EIT-team/Lulzbot_TAZ6_Stuff/Camera_Mount/images/a3205602460fbbdce965ac1f9e4c987e_preview_featured.jpg

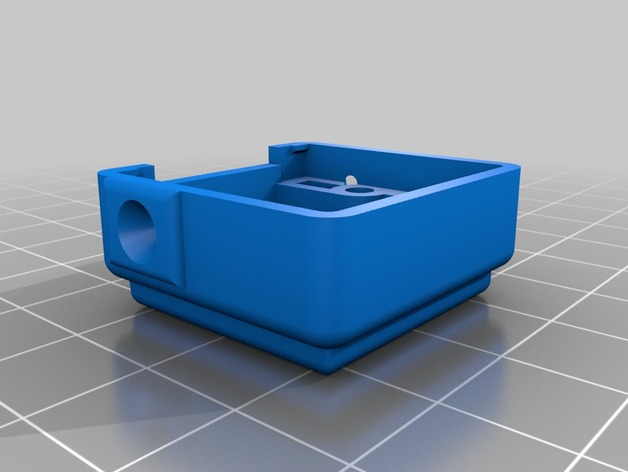
Camera_Mount/images/a3205602460fbbdce965ac1f9e4c987e_preview_featured.jpg
