EIT-team/Lulzbot_TAZ6_Stuff/Spool_holder/images/ad2b357367d83386ae0fbfb51b6cadb3_preview_featured.JPG

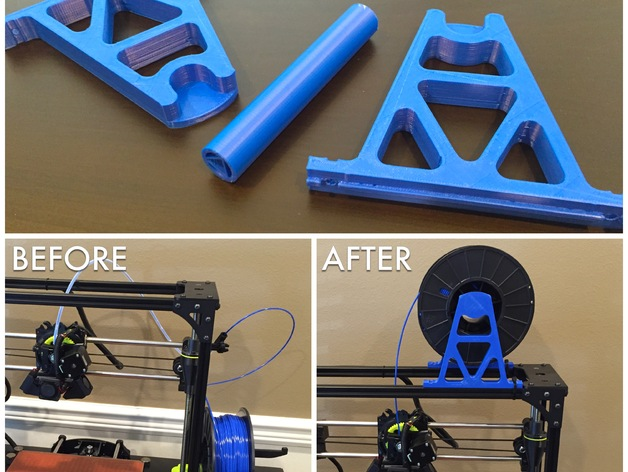
Spool_holder/images/ad2b357367d83386ae0fbfb51b6cadb3_preview_featured.JPG
