EIT-team/Lulzbot_TAZ6_Stuff/Camera_Mount/images/7fdee502b70e45b4f5864df7f136ed26_preview_featured.JPG

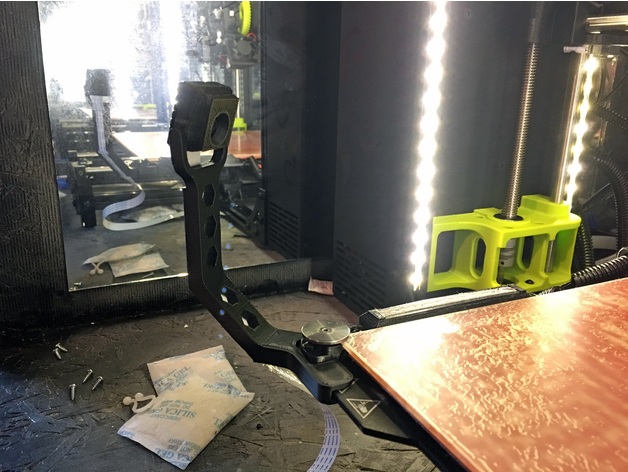
Camera_Mount/images/7fdee502b70e45b4f5864df7f136ed26_preview_featured.JPG
