EIT-team/Lulzbot_TAZ6_Stuff/Camera_Mount/images/425e3a9a2d6e7629a2fc0dd1533b383d_preview_featured.JPG

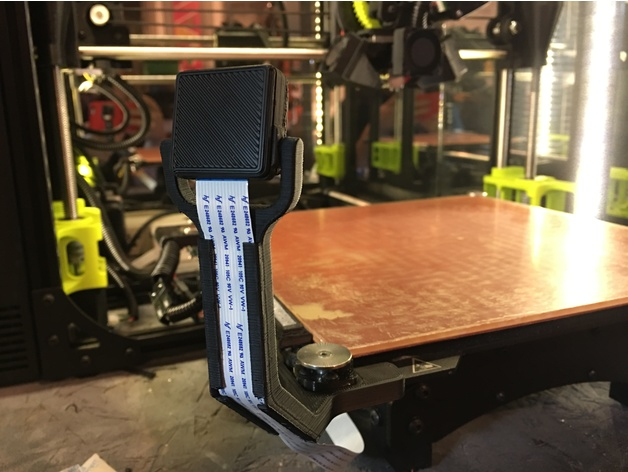
Camera_Mount/images/425e3a9a2d6e7629a2fc0dd1533b383d_preview_featured.JPG
