EIT-team/Lulzbot_TAZ6_Stuff/Camera_Mount/images/969a5c4e11afb6a8e6aaa260e8c08da8_preview_featured.jpg

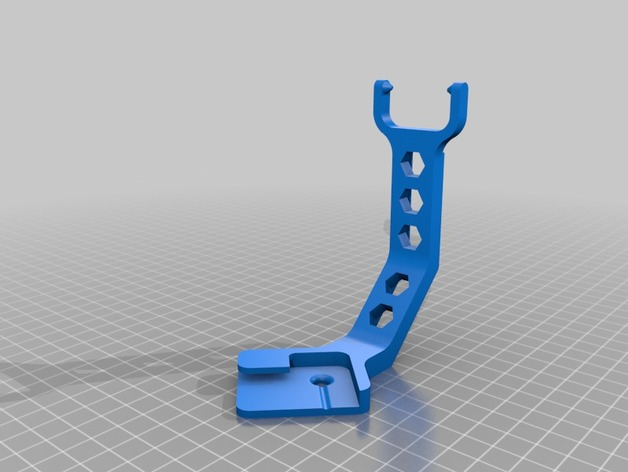
Camera_Mount/images/969a5c4e11afb6a8e6aaa260e8c08da8_preview_featured.jpg
