EIT-team/Lulzbot_TAZ6_Stuff/Camera_Mount/images/603722a2154b18a745f2940e1e3ba9a8_preview_featured.jpg

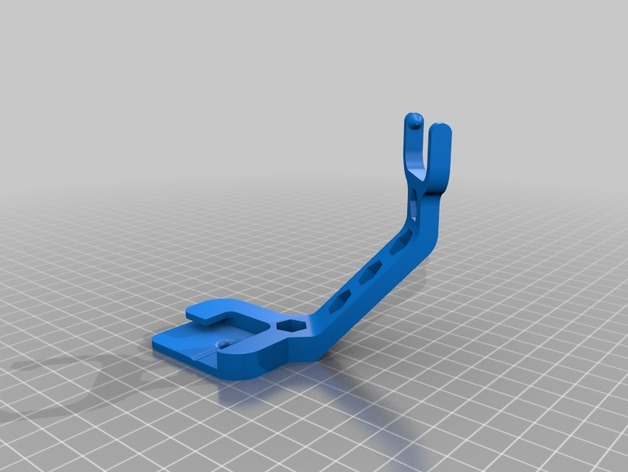
Camera_Mount/images/603722a2154b18a745f2940e1e3ba9a8_preview_featured.jpg
