EIT-team/Lulzbot_TAZ6_Stuff/Camera_Mount/images/ca3ec1ea09c678b3015d4c37807ddfab_preview_featured.jpeg

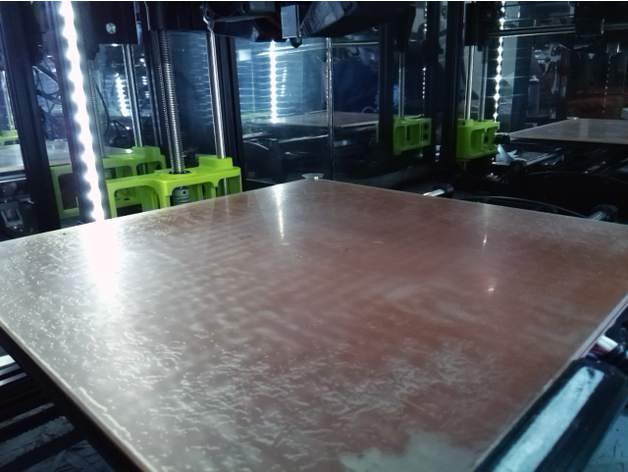
Camera_Mount/images/ca3ec1ea09c678b3015d4c37807ddfab_preview_featured.jpeg
