EIT-team/Lulzbot_TAZ6_Stuff/Spool_holder/images/2ec2b8d2024acbcaface70489fa3a40f_preview_featured.jpg

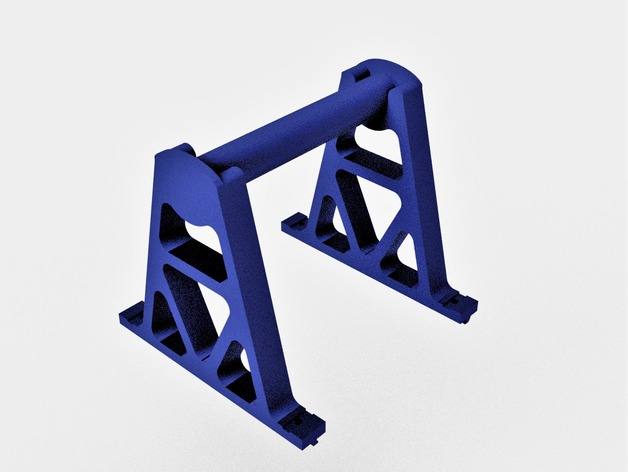
Spool_holder/images/2ec2b8d2024acbcaface70489fa3a40f_preview_featured.jpg
