EIT-team/Lulzbot_TAZ6_Stuff/Spool_holder/images/14ede1b06ad91b893148e72bddfda450_preview_featured.jpg

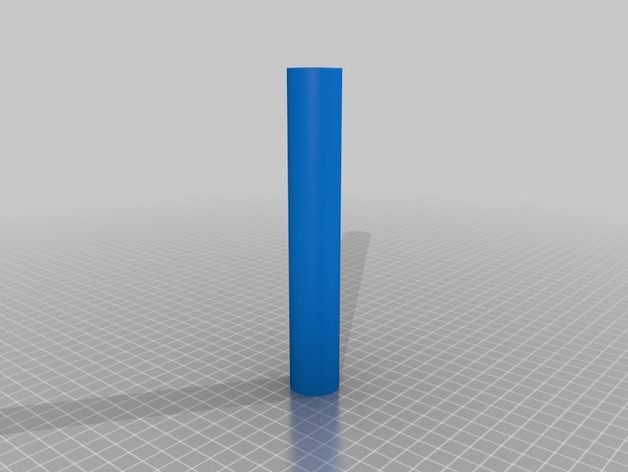
Spool_holder/images/14ede1b06ad91b893148e72bddfda450_preview_featured.jpg
