EIT-team/Lulzbot_TAZ6_Stuff/Spool_holder/images/26fea92ff83ab8327c555f57df6255c9_preview_featured.JPG

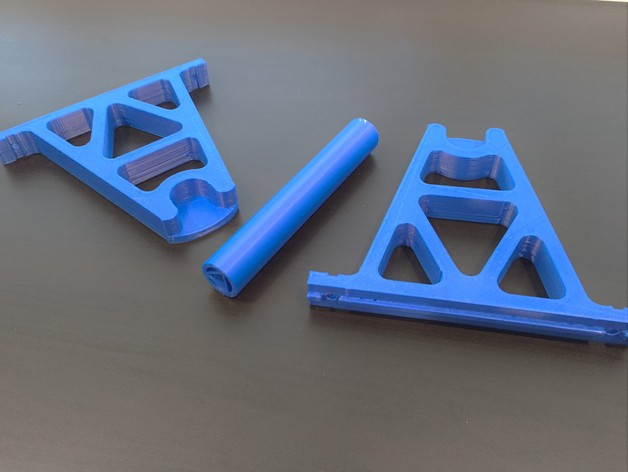
Spool_holder/images/26fea92ff83ab8327c555f57df6255c9_preview_featured.JPG
