EIT-team/Lulzbot_TAZ6_Stuff/Spool_holder/images/42b8552c151d47d23c200a5aa9578fc7_preview_featured.JPG

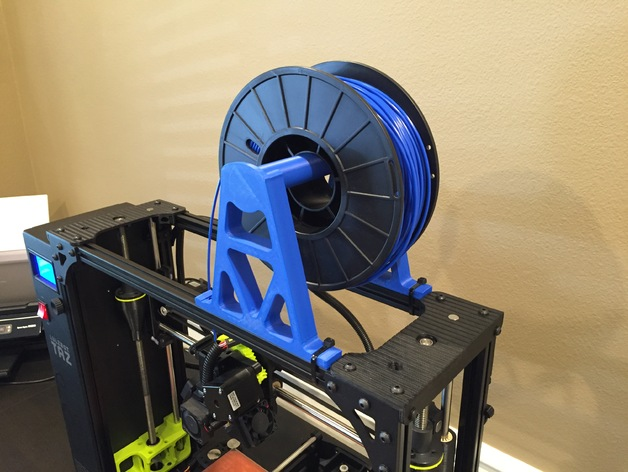
Spool_holder/images/42b8552c151d47d23c200a5aa9578fc7_preview_featured.JPG
