EIT-team/Lulzbot_TAZ6_Stuff/Spool_holder/images/520cf66f8c995ce6bb19e844736197bf_preview_featured.JPG

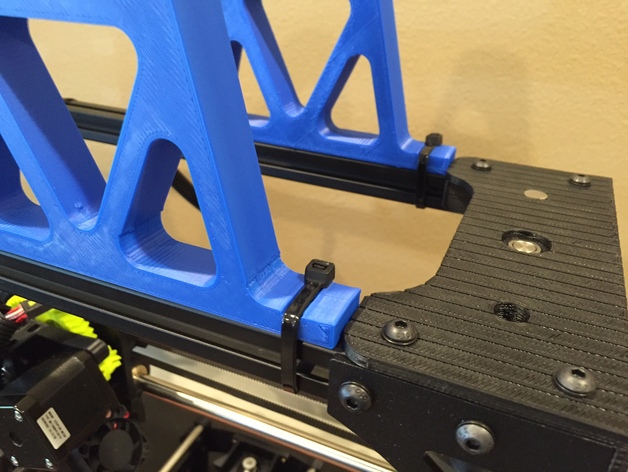
Spool_holder/images/520cf66f8c995ce6bb19e844736197bf_preview_featured.JPG
