EIT-team/Lulzbot_TAZ6_Stuff/Spool_holder/images/714c1ff9d83f5040b42f4c38db04033b_preview_featured.jpg

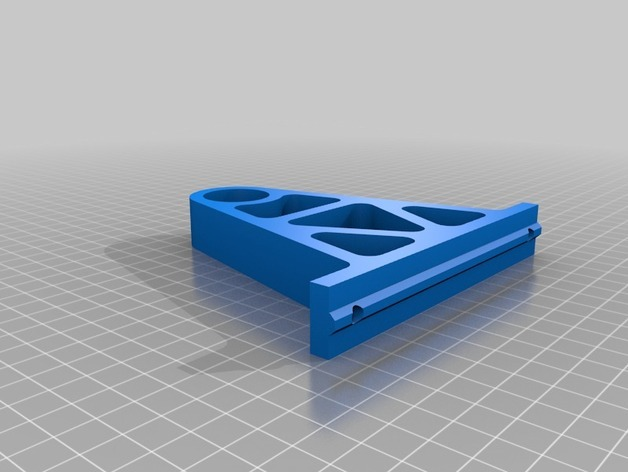
Spool_holder/images/714c1ff9d83f5040b42f4c38db04033b_preview_featured.jpg
