EIT-team/Lulzbot_TAZ6_Stuff/3D_model/Main Assembly.SLDASM

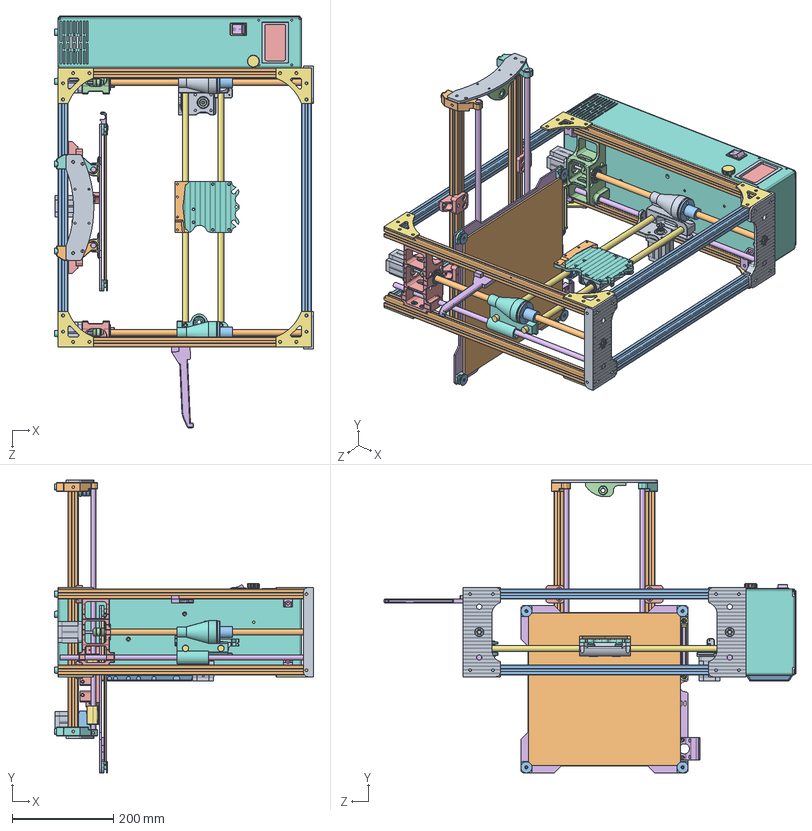
[picture p14: CAD file, 2017-05-05]
3D_model/Main Assembly.SLDASM
511.0 x 577.4 x 812.5 mm
z_upper_v2.4 x 2
20-2020-500-CL x 6
20-2020-510-CL x 4
z_lower_right_v2.3
z_lower_left_v2.3
corner_bracket_v2.0_PP-MP0106 x 8
flexy_bed_foot_v0.1 x 9
step motor x 4
_MTSTRK12-420-F7-R8-T12-Q8-S10-E5-FE0-FW7-FY1 x 2
bearing x 8
Helical Flexible Shaft Coupling x 2
bed_mount_chassis_v3.3 x 4
spool_arm_v0.2
z_carriage_idler_v2.7
z_carriage_motor_v2.7
flexy_washer_v0.1 x 2
_MTSRR12 x 2
R5 TERM F x 4
R5 ACTUATOR F RED ILLUM
R5 BODY-20A-16A
y_corner_right_v2.4-x2 x 2
y_corner_left_v2.41 x 2
y_motor_mount_v3.0
y_idler_mount_v4.0
bed_mount_table_v3.1 x 4
bed_plate_v4.5_PP-MP0108
bearing_holder_v1.0 x 4
bed_corner_taz6_v2 x 4
RJMP-01-10 x 4
GLASS TABLE
bed_leveling_washer_v2.0_PP-MP0082_rev_IR x 4
y_belt_mount_0.75
z-min_switch_mount_v4.1
wiper_mount_v1.1
RJMP-01-12 x 3
