EIT-team/Lulzbot_TAZ6_Stuff/Enclosure/Hinge_Complete.sldasm

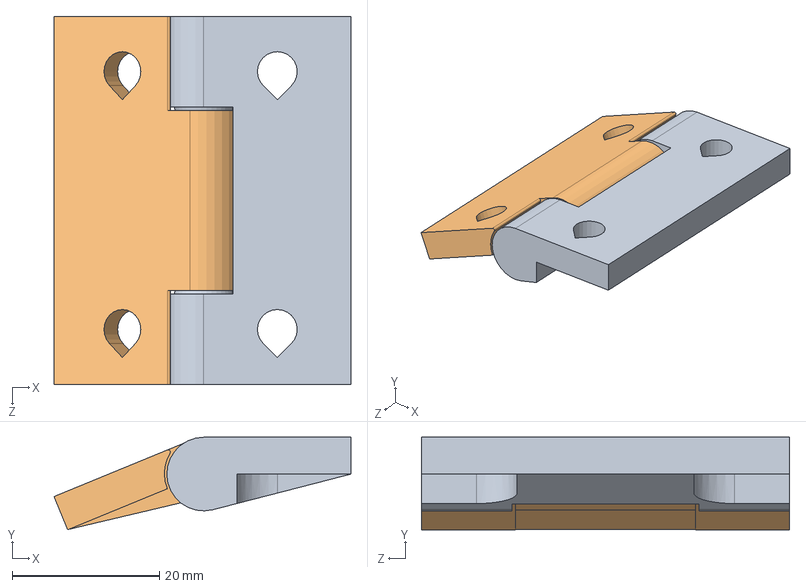
[picture p16: CAD file, 2017-07-31]
Enclosure/Hinge_Complete.sldasm
40.3 x 12.6 x 50.0 mm
Hinge_A
Hinge_B
