EIT-team/Lulzbot_TAZ6_Stuff/Enclosure/Hinge_For_Printing.SLDASM

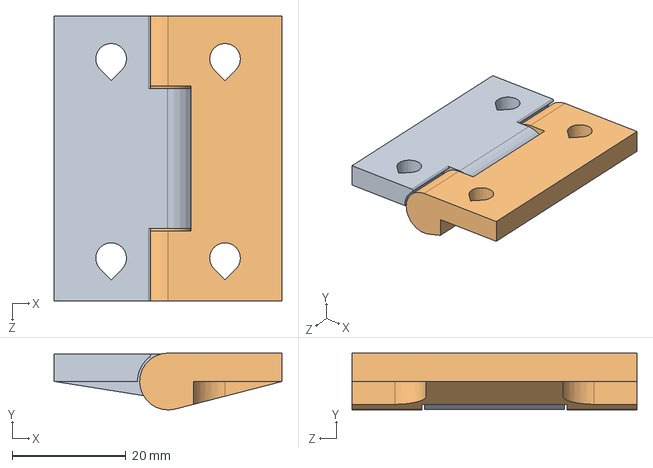
[picture p17: CAD file, 2017-07-31]
Enclosure/Hinge_For_Printing.SLDASM
40.0 x 10.00 x 50.0 mm
Hinge_B
Hinge_A
