EIT-team/Lulzbot_TAZ6_Stuff/Enclosure/Laser_Assembly.SLDASM

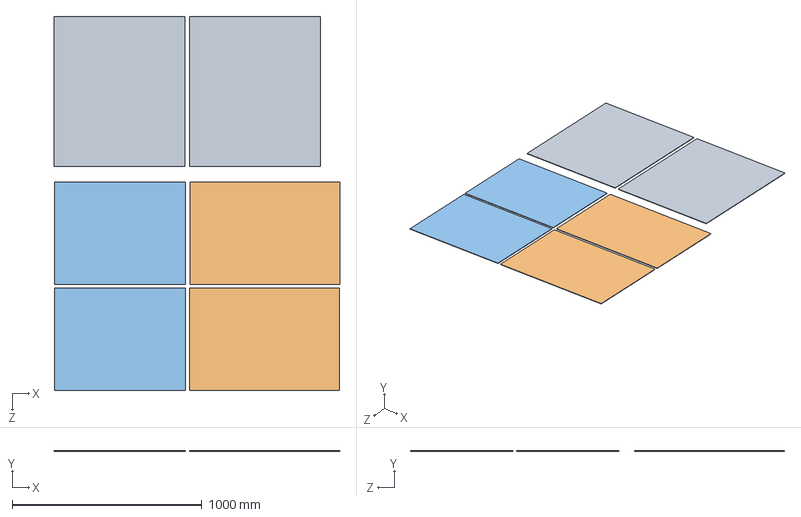
[picture p18: CAD file, 2017-05-08]
Enclosure/Laser_Assembly.SLDASM
1505.4 x 3.00 x 1970.3 mm
Top_Bottom x 2
Front_Back x 2
Side x 2
