EIT-team/Lulzbot_TAZ6_Stuff/Camera_Mount/files/caseBack.stl

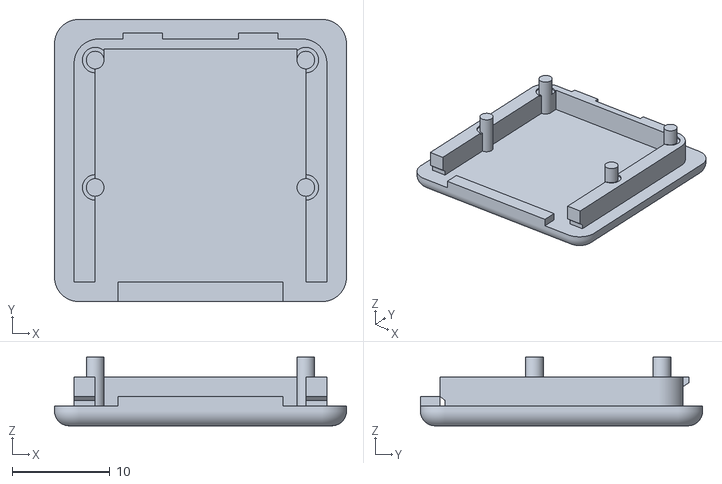
[picture p19: CAD file, 2018-02-23]
Camera_Mount/files/caseBack.stl
29.8 x 28.8 x 7.00
