EIT-team/Lulzbot_TAZ6_Stuff/Filament_Clip/Filament_clip.SLDPRT

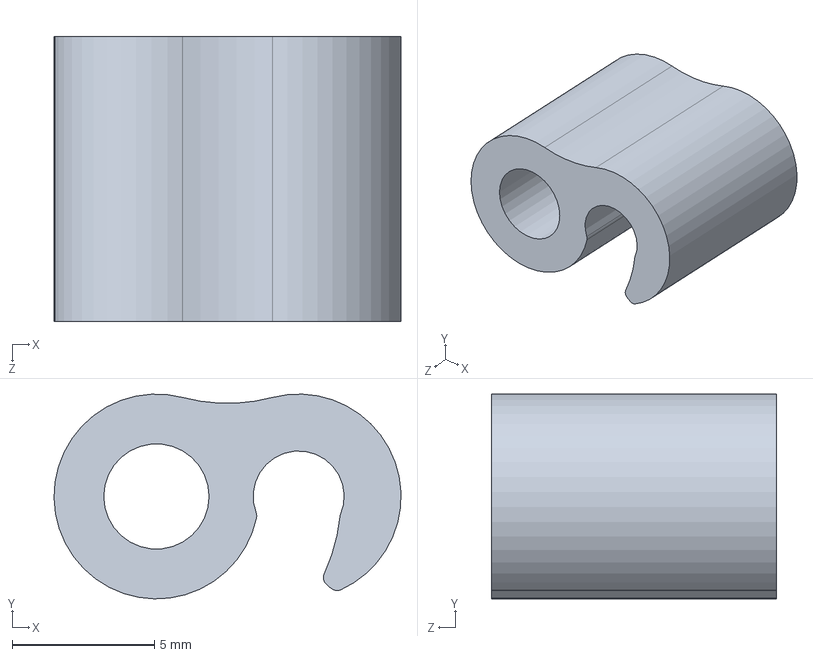
[picture p20: CAD file, 2017-05-09]
Filament_Clip/Filament_clip.SLDPRT
12.2 x 7.20 x 10.0 mm
