EIT-team/Lulzbot_TAZ6_Stuff/Spool_holder/files/TubeForSpoolHolder15b.stl

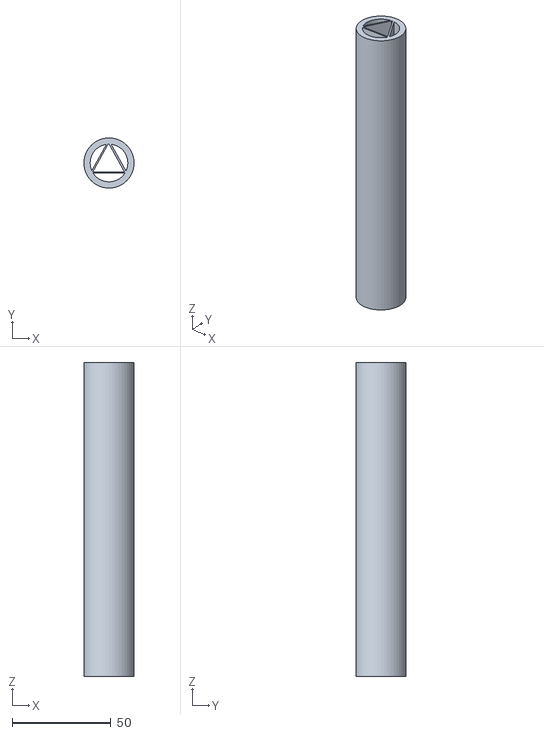
[picture p21: CAD file, 2017-05-05]
Spool_holder/files/TubeForSpoolHolder15b.stl
25.4 x 25.4 x 158.8
