EIT-team/Lulzbot_TAZ6_Stuff/Camera_Mount/files/mountpivot.stl

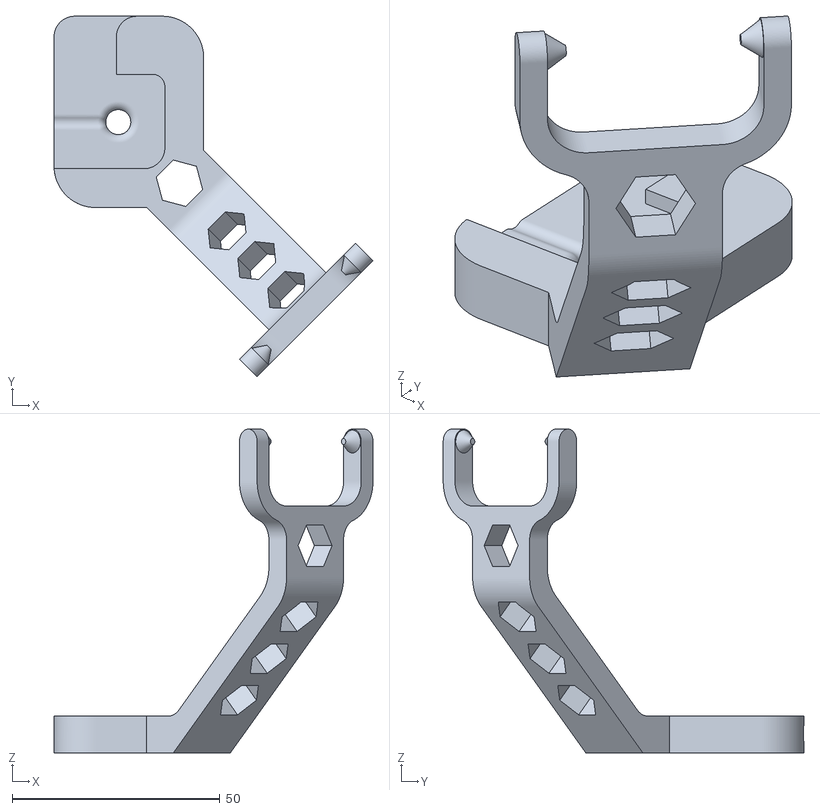
[picture p22: CAD file, 2018-02-23]
Camera_Mount/files/mountpivot.stl
76.7 x 86.7 x 77.9
