EIT-team/Lulzbot_TAZ6_Stuff/Spool_holder/files/ModSpoolTower15_single.stl

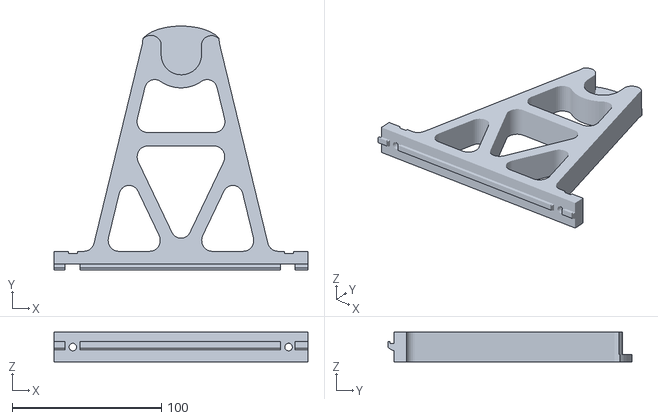
[picture p23: CAD file, 2017-05-05]
Spool_holder/files/ModSpoolTower15_single.stl
170.0 x 163.4 x 20.0
