EIT-team/Lulzbot_TAZ6_Stuff/Camera_Mount/files/tallmountpivot.stl

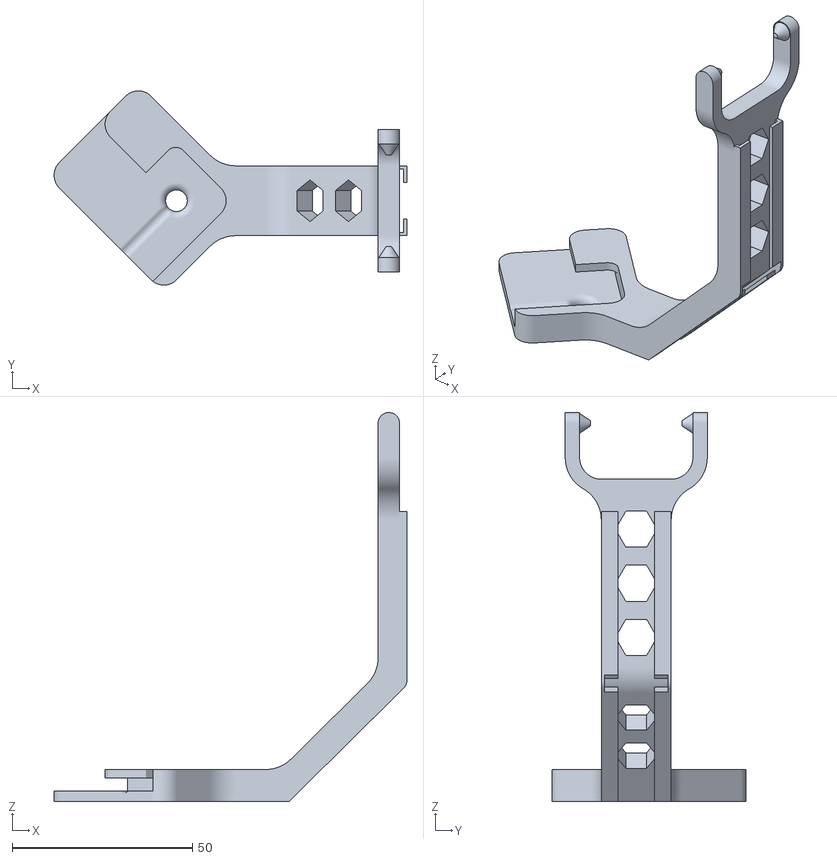
[picture p24: CAD file, 2018-02-23]
Camera_Mount/files/tallmountpivot.stl
97.8 x 53.8 x 107.9
