EIT-team/Lulzbot_TAZ6_Stuff/Enclosure/Hinge_B.SLDPRT

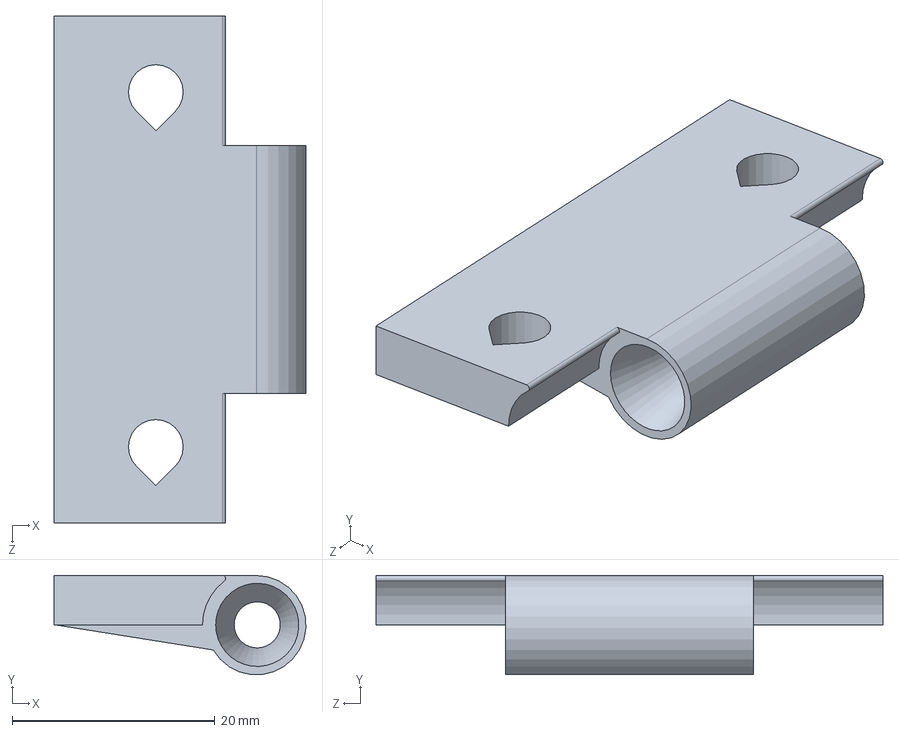
[picture p25: CAD file, 2017-07-31]
Enclosure/Hinge_B.SLDPRT
24.8 x 9.77 x 50.0 mm
