EIT-team/Lulzbot_TAZ6_Stuff/Enclosure/Top_Bottom.SLDPRT

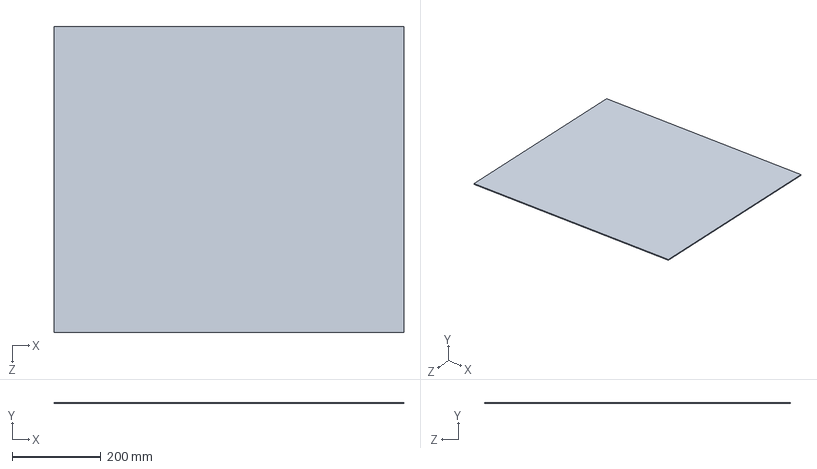
[picture p26: CAD file, 2017-07-18]
Enclosure/Top_Bottom.SLDPRT
790.0 x 3.00 x 690.0 mm
