EIT-team/Lulzbot_TAZ6_Stuff/Enclosure/SpoolHolder.SLDPRT

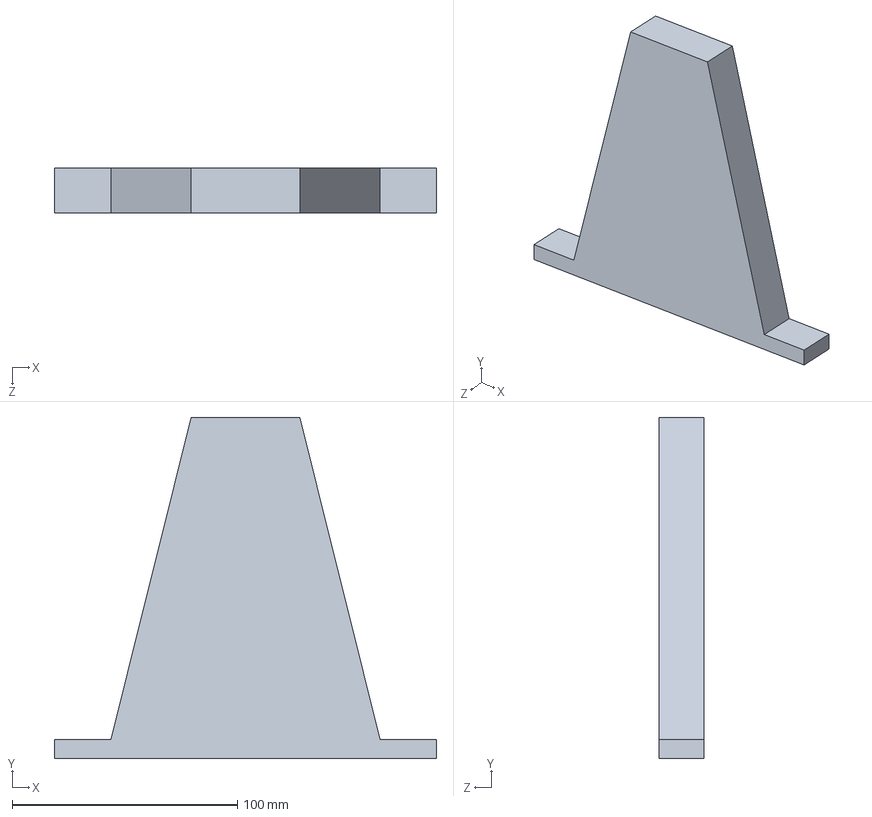
[picture p27: CAD file, 2017-07-18]
Enclosure/SpoolHolder.SLDPRT
169.5 x 151.5 x 20.0 mm
