EIT-team/Lulzbot_TAZ6_Stuff/Enclosure/Hinge_A.SLDPRT

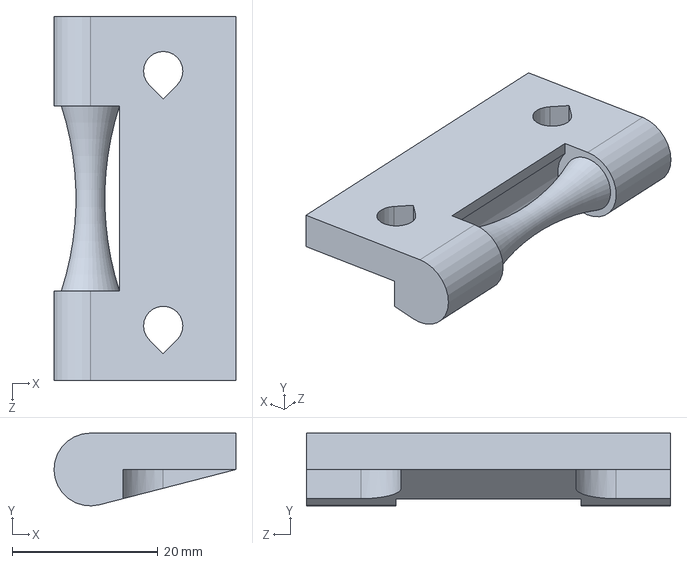
[picture p28: CAD file, 2017-07-18]
Enclosure/Hinge_A.SLDPRT
25.0 x 10.00 x 50.0 mm
