EIT-team/Lulzbot_TAZ6_Stuff/Enclosure/Cutting_jig.SLDPRT

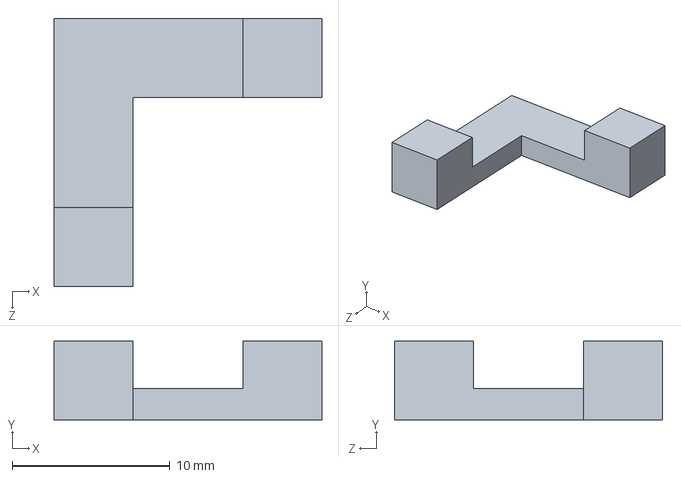
[picture p29: CAD file, 2017-07-18]
Enclosure/Cutting_jig.SLDPRT
17.0 x 5.00 x 17.0 mm
