EIT-team/Lulzbot_TAZ6_Stuff/Enclosure/Corner_bracket.SLDPRT

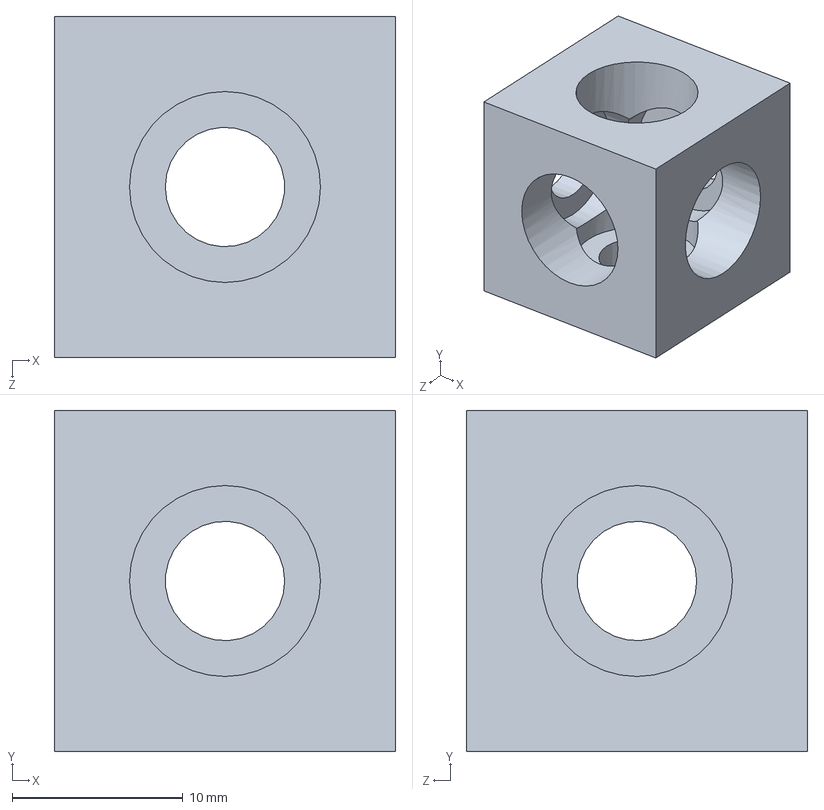
[picture p30: CAD file, 2017-05-08]
Enclosure/Corner_bracket.SLDPRT
20.0 x 20.0 x 20.0 mm
