EIT-team/Lulzbot_TAZ6_Stuff/Enclosure/Side.SLDPRT

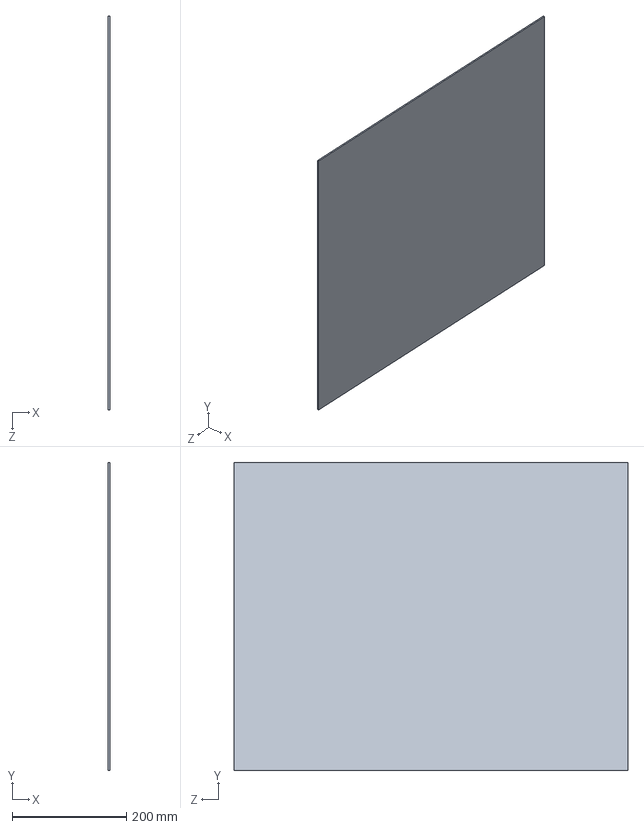
[picture p31: CAD file, 2017-05-08]
Enclosure/Side.SLDPRT
3.00 x 540.0 x 690.0 mm
