EIT-team/Lulzbot_TAZ6_Stuff/Enclosure/Front_Back.SLDPRT

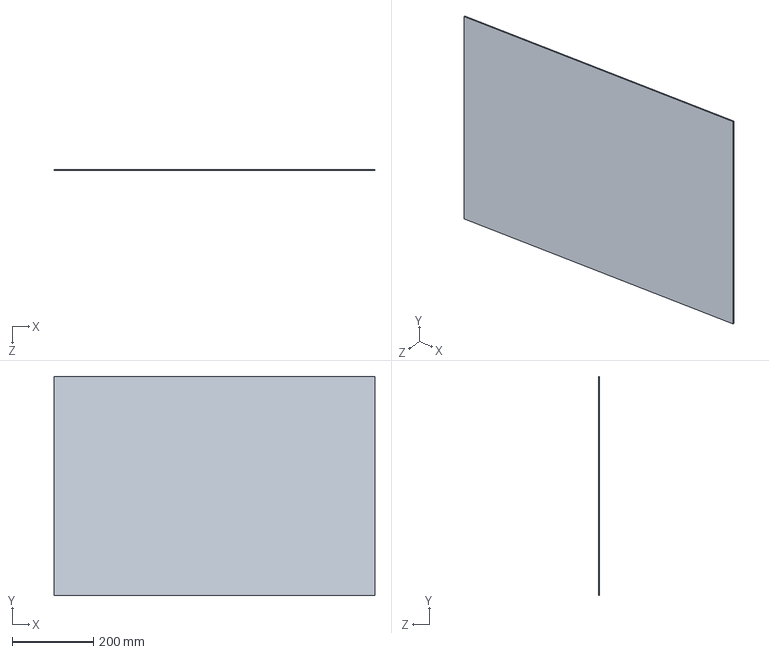
[picture p32: CAD file, 2017-05-08]
Enclosure/Front_Back.SLDPRT
790.0 x 540.0 x 3.00 mm
