EIT-team/Lulzbot_TAZ6_Stuff/Enclosure/Vslot_2020.SLDPRT

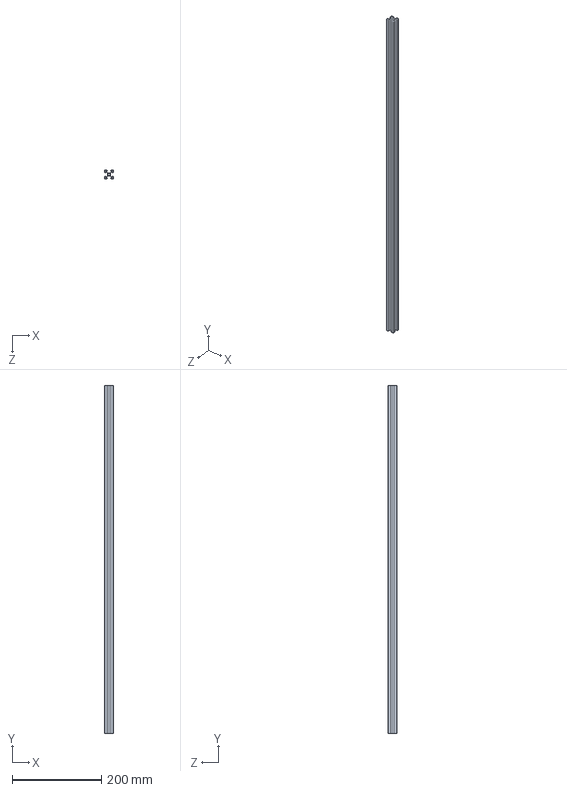
[picture p33: CAD file, 2017-05-05]
Enclosure/Vslot_2020.SLDPRT
20.0 x 780.0 x 20.0 mm
