EIT-team/Lulzbot_TAZ6_Stuff/Enclosure/Door_handle.SLDPRT

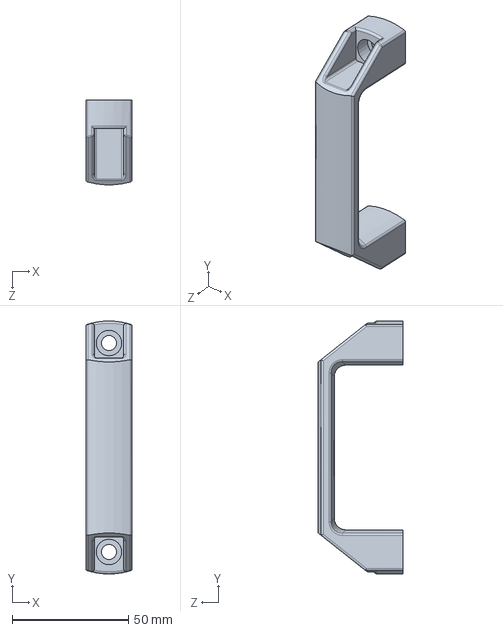
[picture p34: CAD file, 2017-05-05]
Enclosure/Door_handle.SLDPRT
20.0 x 109.0 x 36.4 mm
