EIT-team/Lulzbot_TAZ6_Stuff/(list of files, cad)

Other CAD files:
3D_model/Components/X axis carriage assembly _1_.sldasm
3D_model/Components/Y axis table assembly _1_.sldasm
3D_model/Components/Y axis base assembly _1_.sldasm
3D_model/Components/Assembly2 _1_.sldasm
3D_model/Components/Electronics enclosure assembly _1_.sldasm
3D_model/Components/X axis assembly _1_.sldasm
3D_model/Components/Frame and Z axis assembly _1_.sldasm
3D_model/Components/z_upper_v2.4.sldprt
3D_model/Components/z_lower_right_v2.3.sldprt
3D_model/Components/z_carriage_idler_v2.7.sldprt
3D_model/Components/y_corner_right_v2.4-x2.sldprt
3D_model/Components/step motor.sldprt
3D_model/Components/Part 1.sldprt
3D_model/Components/Pocket002.sldprt
3D_model/Components/Part 1-4.sldprt
3D_model/Components/corner_bracket_v2.0_PP-MP0106.sldprt
3D_model/Components/Fillet002.sldprt
3D_model/Components/Part 1-5.sldprt
3D_model/Components/flexy_bed_foot_v0.1.sldprt
3D_model/Components/bed_plate_v4.5_PP-MP0108.sldprt
3D_model/Components/y_belt_mount_0.75.sldprt
3D_model/Components/bearing.sldprt
3D_model/Components/Chamfer001.sldprt
3D_model/Components/R5 ACTUATOR F RED ILLUM.sldprt
3D_model/Components/20-2020-510-CL.sldprt
3D_model/Components/13.sldprt
3D_model/Components/Part 1-2.sldprt
3D_model/Components/Part 1-1.sldprt
3D_model/Components/R5 TERM F.sldprt
3D_model/Components/z-min_switch_mount_v4.1.sldprt
3D_model/Components/RJMP-01-10.sldprt
3D_model/Components/Fillet.sldprt
3D_model/Components/20-2020-500-CL.sldprt
3D_model/Components/Fillet-2.sldprt
3D_model/Components/z_lower_left_v2.3.sldprt
3D_model/Components/wiper_mount_v1.1.sldprt
3D_model/Components/R5 BODY-20A-16A.sldprt
3D_model/Components/_MTSRR12.sldprt
3D_model/Components/Fillet001.sldprt
3D_model/Components/y_idler_mount_v4.0.sldprt
3D_model/Components/Fillet-1.sldprt
3D_model/Components/_MTSTRK12-420-F7-R8-T12-Q8-S10-E5-FE0-FW7-FY1.sldprt
3D_model/Components/bearing_holder_v1.0.sldprt
3D_model/Components/Part 1-3.sldprt
3D_model/Components/y_corner_left_v2.41.sldprt
3D_model/Components/RJMP-01-12.sldprt
3D_model/Components/Helical Flexible Shaft Coupling.sldprt
3D_model/Components/y_motor_mount_v3.0.sldprt
3D_model/Components/bed_mount_chassis_v3.3.sldprt
3D_model/Components/Pocket002-1.sldprt
3D_model/Components/Pocket008.sldprt
3D_model/Components/bed_mount_table_v3.1.sldprt
3D_model/Components/z_carriage_motor_v2.7.sldprt
3D_model/Components/spool_arm_v0.2.sldprt
3D_model/Components/bed_corner_taz6_v2.sldprt
3D_model/Components/Chamfer001-1.sldprt
3D_model/Components/GLASS TABLE.sldprt
3D_model/Components/bed_leveling_washer_v2.0_PP-MP0082_rev_IR.sldprt
3D_model/Components/flexy_washer_v0.1.sldprt
Enclosure/Hinge_Complete.STL
Enclosure/Hinge_For_Printing.STL
Enclosure/old/Component1.sldprt
Enclosure/old/Component2.sldprt
Enclosure/old/Cube Corner Connector v1.sldprt
Enclosure/old/Enclosure v20.SLDASM
Enclosure/old/Enclosure v20.step
Enclosure/old/Foot v6.sldasm
Enclosure/old/Foot v6_2.sldasm
Enclosure/old/Foot v6_3.sldasm
Enclosure/old/Foot v6_4.sldasm
Enclosure/old/Foot.sldprt
Enclosure/old/Glazing Strip.sldprt
Enclosure/old/Glide.sldprt
Enclosure/old/Glider v3.sldasm
Enclosure/old/Hinge v8.sldasm
Enclosure/old/Hinge v8.step
Enclosure/old/Hinge v8_2.sldasm
Enclosure/old/Low Profile Screw M5 v1.sldprt
Enclosure/old/V-Slot Door Handle v1.sldprt
Enclosure/old/Window (front_back).sldprt
Enclosure/old/Window (side).sldprt
Enclosure/old/Window (top).sldprt
Enclosure/old/v-slot-2020 (cornerX).sldprt
Enclosure/old/v-slot-2020 (cornerY).sldprt
Enclosure/old/v-slot-2020 (cornerZ).sldprt
Enclosure/old/v-slot-2020 (doorX).sldprt
Enclosure/old/v-slot-2020 (doorZ).sldprt
Filament_Clip/Filament_clip.STL
