EIT-team/Lulzbot_TAZ6_Stuff/guide_images/Cura_manage_printers.png

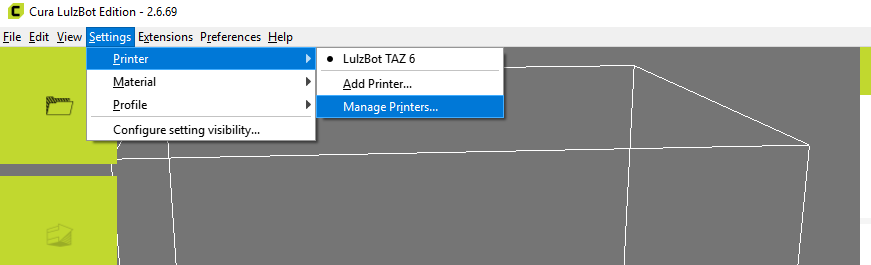
guide_images/Cura_manage_printers.png
