EIT-team/Lulzbot_TAZ6_Stuff/guide_images/Cura_octoprintsettings.png

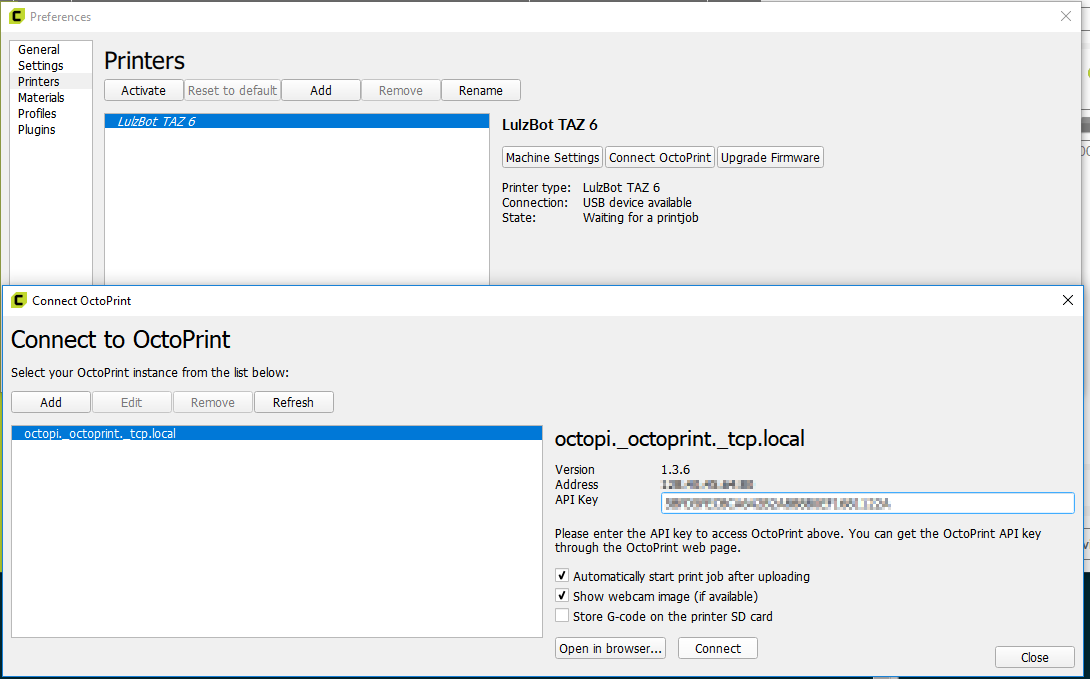
guide_images/Cura_octoprintsettings.png
