EIT-team/Lulzbot_TAZ6_Stuff/guide_images/Cura_print_ready.png

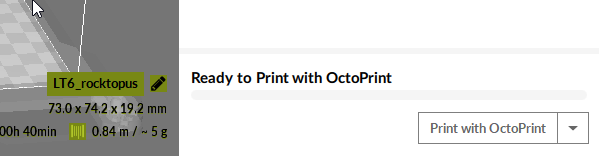
guide_images/Cura_print_ready.png
