EIT-team/Lulzbot_TAZ6_Stuff/guide_images/Octoprint_API.png

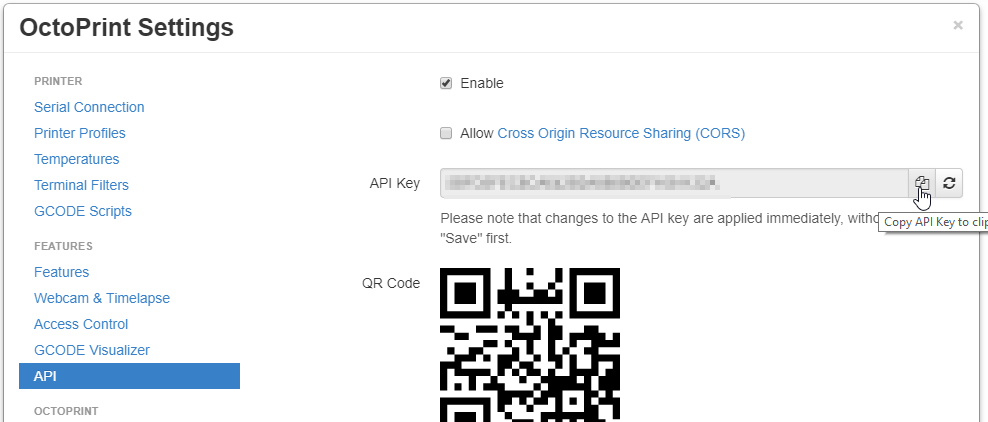
guide_images/Octoprint_API.png
