EIT-team/Lulzbot_TAZ6_Stuff/guide_images/Octoprint_gcode_viewer.png

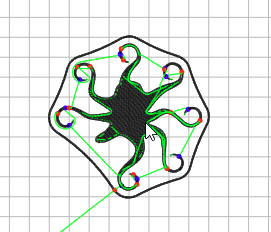
guide_images/Octoprint_gcode_viewer.png
