EIT-team/Lulzbot_TAZ6_Stuff/guide_images/Octoprint_homepage.png

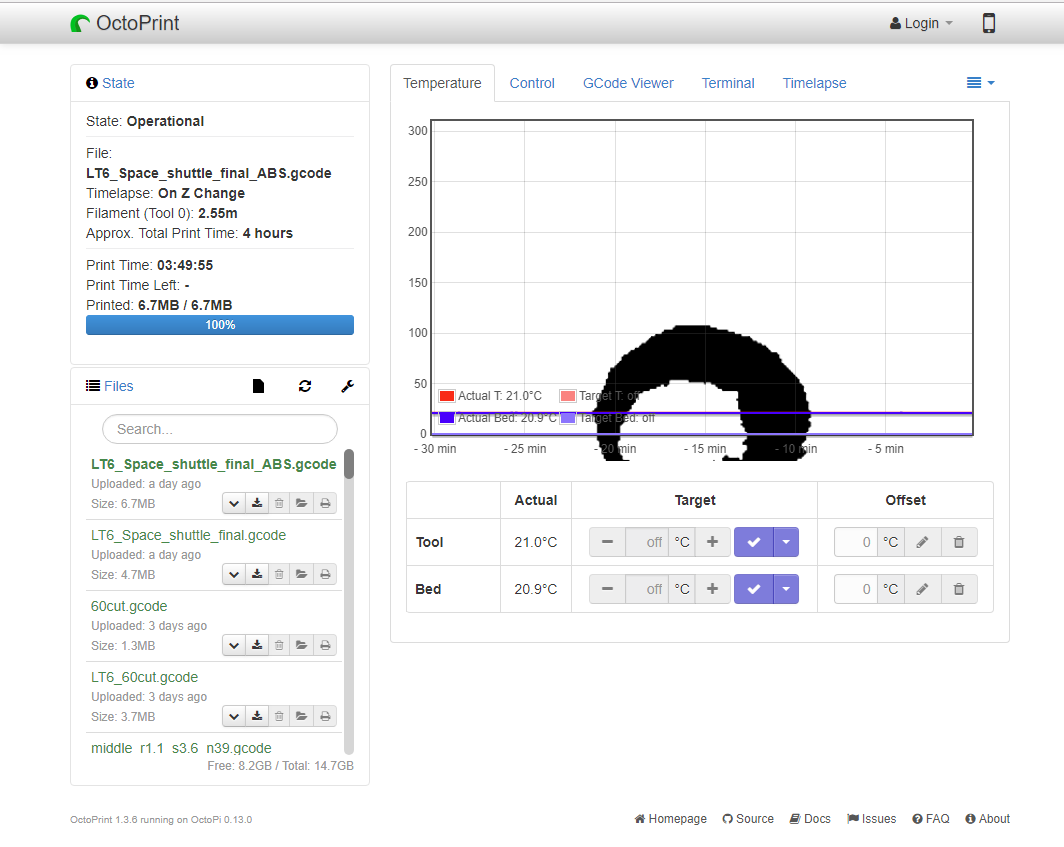
guide_images/Octoprint_homepage.png
