EIT-team/Lulzbot_TAZ6_Stuff/guide_images/Octoprint_upload.png

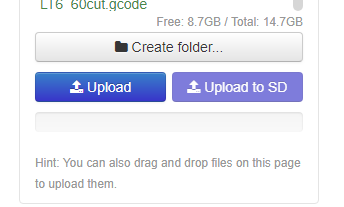
guide_images/Octoprint_upload.png
