EIT-team/Lulzbot_TAZ6_Stuff/(commit log)

2017-05-05 Inital commit with CAD model, spool holder and example enclosure
    [13.sldprt, 20-2020-500-CL.sldprt, 20-2020-510-CL.sldprt, Assembly2 _1_.sldasm, Chamfer001-1.sldprt, Chamfer001.sldprt, Component1.sldprt, Component2.sldprt]
2017-05-08 First version of Enclosure drawing
    [Corner_bracket.SLDPRT, Enclosure v20.SLDASM, Front_Back.SLDPRT, Glider v3.sldasm, Hinge v8.sldasm, Hinge v8_2.sldasm, Hinge_A.SLDPRT, Hinge_B.SLDPRT]
2017-05-09 Added filament clip
    [Filament_clip.SLDPRT, Filament_clip.STL]
2017-07-18 Added files for Spool Holder, and hinge
    [Cutting_jig.SLDPRT, Hinge_A.SLDPRT, Hinge_B.SLDPRT, Hinge_Complete.STL, Hinge_Complete.sldasm, SpoolHolder.SLDPRT, Taz_enclosure.SLDASM, Top_Bottom.SLDPRT]
2017-07-31 Adjusted hinge to fit
    [Hinge_B.SLDPRT, Hinge_Complete.sldasm, Hinge_For_Printing.SLDASM, Hinge_For_Printing.STL, Taz_enclosure.SLDASM, parametric_butt_hinge_3.5.1.scad]
2018-02-01 Added some more links to filament and maintenance
2018-02-23 added camera mount and link to wiki on readme
    [caseBack.stl, mountpivot.stl, tallmountpivot.stl]
